mtgrosser/hack_chime/(commit log)

2017-05-04 Adding circuit
2017-05-04 Add PCB
2017-05-31 Device image
